OnanAgaba/low-cost-soil-moisture-datalogger/README.md

This repository provides resources for the project **"Comparative Performance of Four Soil Moisture Sensors in Arid Conditions: Low-Cost and Commercial Options"** by Onan Agaba, Mulugeta Weldegebriel Hagos, Fatima-Zahra Kasmi, and Elad Levintal.
     
## Repository Contents

1. **Prototype Design and Raw Sensor Data**
   - Visual diagrams and Initial findings from sensor comparisons.
   - File: *[`low-cost-soil-moisture-datalogger-brief-paper.pdf`](./low-cost-soil-moisture-datalogger-brief-paper.pdf)*
   - Raw data from sensors.
   - File: *[`soillog.csv`](./soillog.csv)* 

2. **Do-It-Yourself Guide**
   - Step-by-step instructions to replicate the soil moisture sensor system.  
   - File: *[`low-cost-soil-moisture-datalogger-guide.pdf`](./low-cost-soil-moisture-datalogger-guide.pdf)*

3. **Arduino Code**
   - The main program that runs the full soil moisture sensor system.  
   - File: *[`low-cost-soil-moisture-datalogger.ino`](./low-cost-soil-moisture-datalogger.ino)*
   - Additional sketches to test and troubleshoot each sensor individually.
   - Folder: [`individual-sensor-test-codes`](./individual-sensor-test-codes/)

---

*For more information or questions, contact: [Onan Agaba](mailto:onanagaba@gmail.com)*
